2BRobots/ThunderBolt-Nova/Ejemplos/MikroC/ServoADC/ServoADC.mcppi_callertable.txt

main
	ADC_Read
	Mul_16X16_U
	Div_16x16_S
		Div_16x16_S_L
	servo
