2BRobots/ThunderBolt-Nova/Ejemplos/mikroBasic/ServoPot/ServoADC.mbppi_callertable.txt

main
	ADC_Init_Advanced
	ADC_Get_Sample
		Delay_22us
	servo
