2BRobots/ThunderBolt-Nova/README.txt

2B Robots (DAFR Electronics) invierte tiempo y recursos en la elaboración de este contenido. Si usted valora nuestro trabajo duro por favor compre nuestros productos o realize una pequeña donacion. Este trabajo se comparte bajo una licencia Creative Commons BY-NC-SA.

Gracias :)

www.2brobots.com
