2BRobots/ThunderBolt-Nova/Ejemplos/MPLAB/ThunderBolt MPLAB example/README.txt

Este es un ejemplo de un programa funcional en MPLAB simplificado. 
Puedes usarlo como plantilla para iniciar tus proyectos.
No hace falta configurar nada mas.
