2BRobots/ThunderBolt-Nova/Ejemplos/MPLAB/Thunder_Bolt_Blinker_template.X/README.txt

Agradecimientos especiales a Leopoldo De Silva Ortiz por enviar la plantilla para hacer un proyecto con ThunderBolt Nova en MPLAB.
