2BRobots/ThunderBolt-Nova/Documentacion/Diagrama - ThunderBolt Nova Pico.pdf

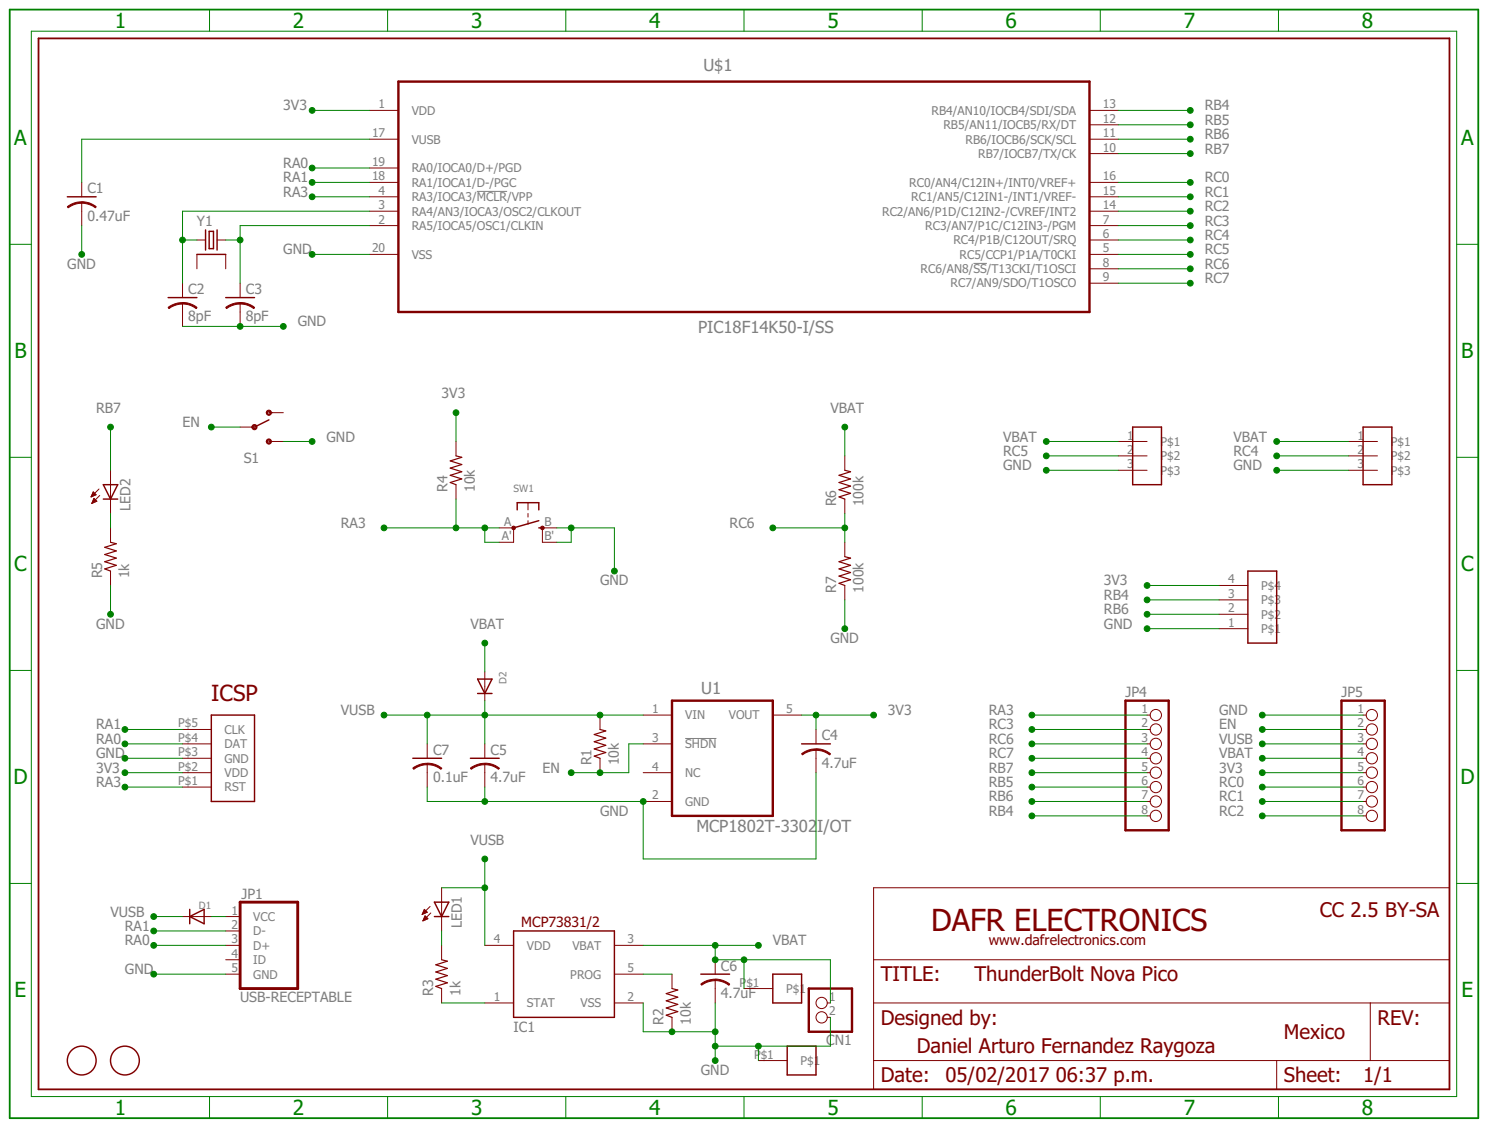
[picture p2: page 1]

CC 2.5 BY-SA DAFR ELECTRONICS

Designed by: Mexico Daniel Arturo Fernandez Raygoza | REV:

Date: 05/02/2017 06:37 p.m. | Sheet: 1/1
