2BRobots/ThunderBolt-Nova/Expansion Boards/Lora_RN2903A/ThunderBolt Lora.brd

## EAGLE design Expansion Boards/Lora_RN2903A/ThunderBolt Lora.brd (2020-08-20)

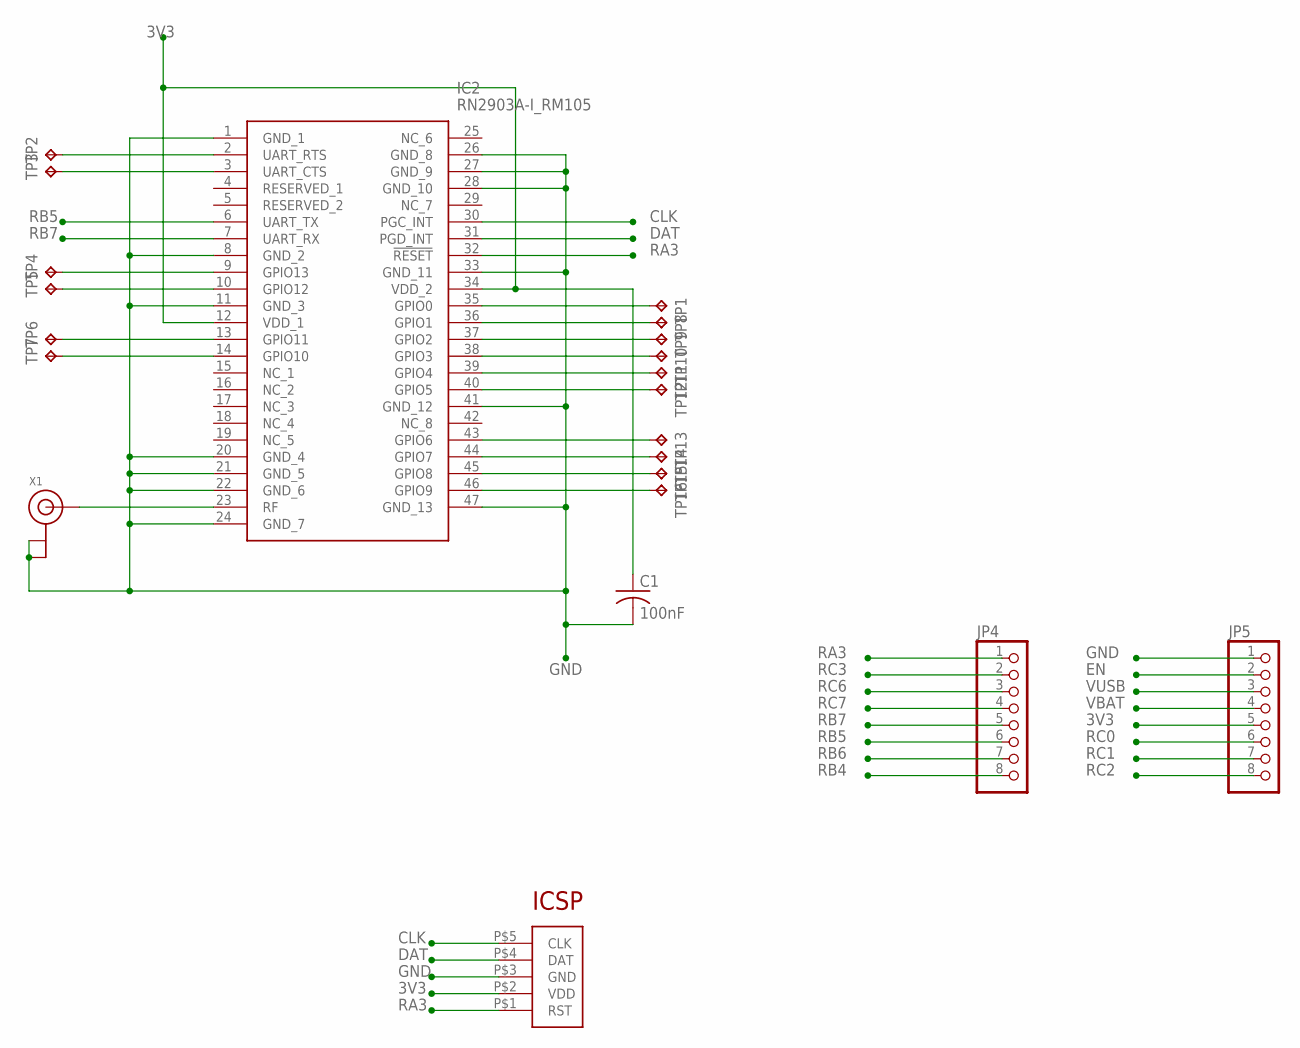
[picture p3: schematic ThunderBolt Lora.sch]

Parts:
C1: 100nF; C0603K
IC2: RN2903A-I_RM105; RN2903AIRM105
JP4, JP5: PINHD-1X8BIG; 1X08-BIG
TP1, TP2, TP3, TP4, TP5, TP6, TP7, TP8, TP9, TP10, TP11, TP12, TP13, TP14, TP15, TP16: TPB1,27; B1,27
U$2: ICSP_POGO
X1: ANTENNA_U.FL; U.FL

Connections:
3V3: C1.1, IC2.12 (VDD_1), IC2.34 (VDD_2), JP5.5, U$2.P$2 (VDD)
CLK: IC2.30 (PGC_INT), U$2.P$5 (CLK)
DAT: IC2.31 (PGD_INT), U$2.P$4 (DAT)
EN: JP5.2
GND: C1.2, IC2.1 (GND_1), IC2.8 (GND_2), IC2.11 (GND_3), IC2.20 (GND_4), IC2.21 (GND_5), IC2.22 (GND_6), IC2.24 (GND_7), IC2.26 (GND_8), IC2.27 (GND_9), IC2.28 (GND_10), IC2.33 (GND_11), IC2.41 (GND_12), IC2.47 (GND_13), JP5.1, U$2.P$3 (GND), X1.1 (GND), X1.2 (GND)
unnamed: IC2.2 (UART_RTS), TP2.TP
unnamed: IC2.3 (UART_CTS), TP3.TP
unnamed: IC2.9 (GPIO13), TP4.TP
unnamed: IC2.10 (GPIO12), TP5.TP
unnamed: IC2.23 (RF), X1.3 (SIGNAL)
unnamed: IC2.13 (GPIO11), TP6.TP
unnamed: IC2.14 (GPIO10), TP7.TP
unnamed: IC2.35 (GPIO0), TP1.TP
unnamed: IC2.46 (GPIO9), TP16.TP
unnamed: IC2.45 (GPIO8), TP15.TP
unnamed: IC2.44 (GPIO7), TP14.TP
unnamed: IC2.43 (GPIO6), TP13.TP
unnamed: IC2.40 (GPIO5), TP12.TP
unnamed: IC2.39 (GPIO4), TP11.TP
unnamed: IC2.38 (GPIO3), TP10.TP
unnamed: IC2.37 (GPIO2), TP9.TP
unnamed: IC2.36 (GPIO1), TP8.TP
RA3: IC2.32 (!RESET), JP4.1, U$2.P$1 (RST)
RB4: JP4.8
RB5: IC2.6 (UART_TX), JP4.6
RB6: JP4.7
RB7: IC2.7 (UART_RX), JP4.5
RC0: JP5.6
RC1: JP5.7
RC2: JP5.8
RC3: JP4.2
RC6: JP4.3
RC7: JP4.4
VBAT: JP5.4
VUSB: JP5.3

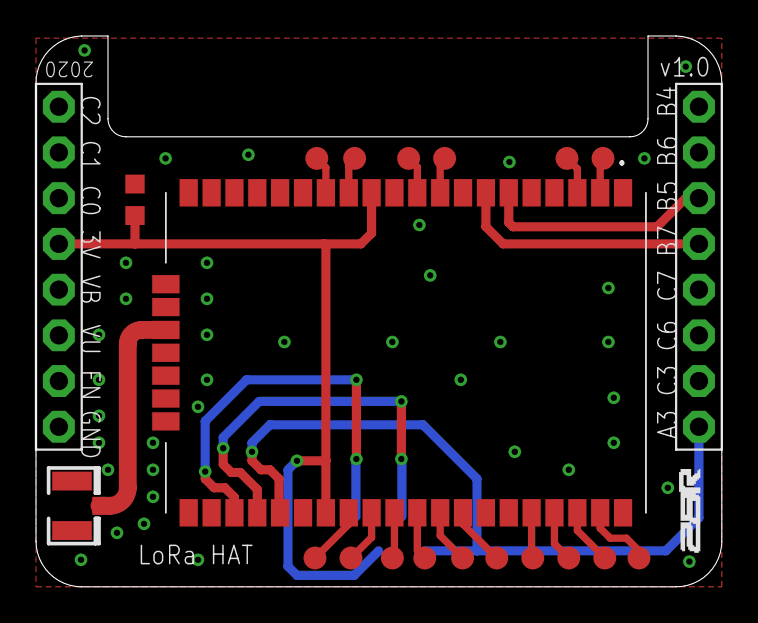
[picture p4: board ThunderBolt Lora.brd from above]

Board: 2 copper layers, 38.1 x 30.6 mm, 22 parts (1 on the bottom side), 24 nets.
