2BRobots/ThunderBolt-Nova/hardware/ThunderBolt Nova/ThunderBolt Nova.sch

## EAGLE design hardware/ThunderBolt Nova/ThunderBolt Nova.sch (2017-04-14)

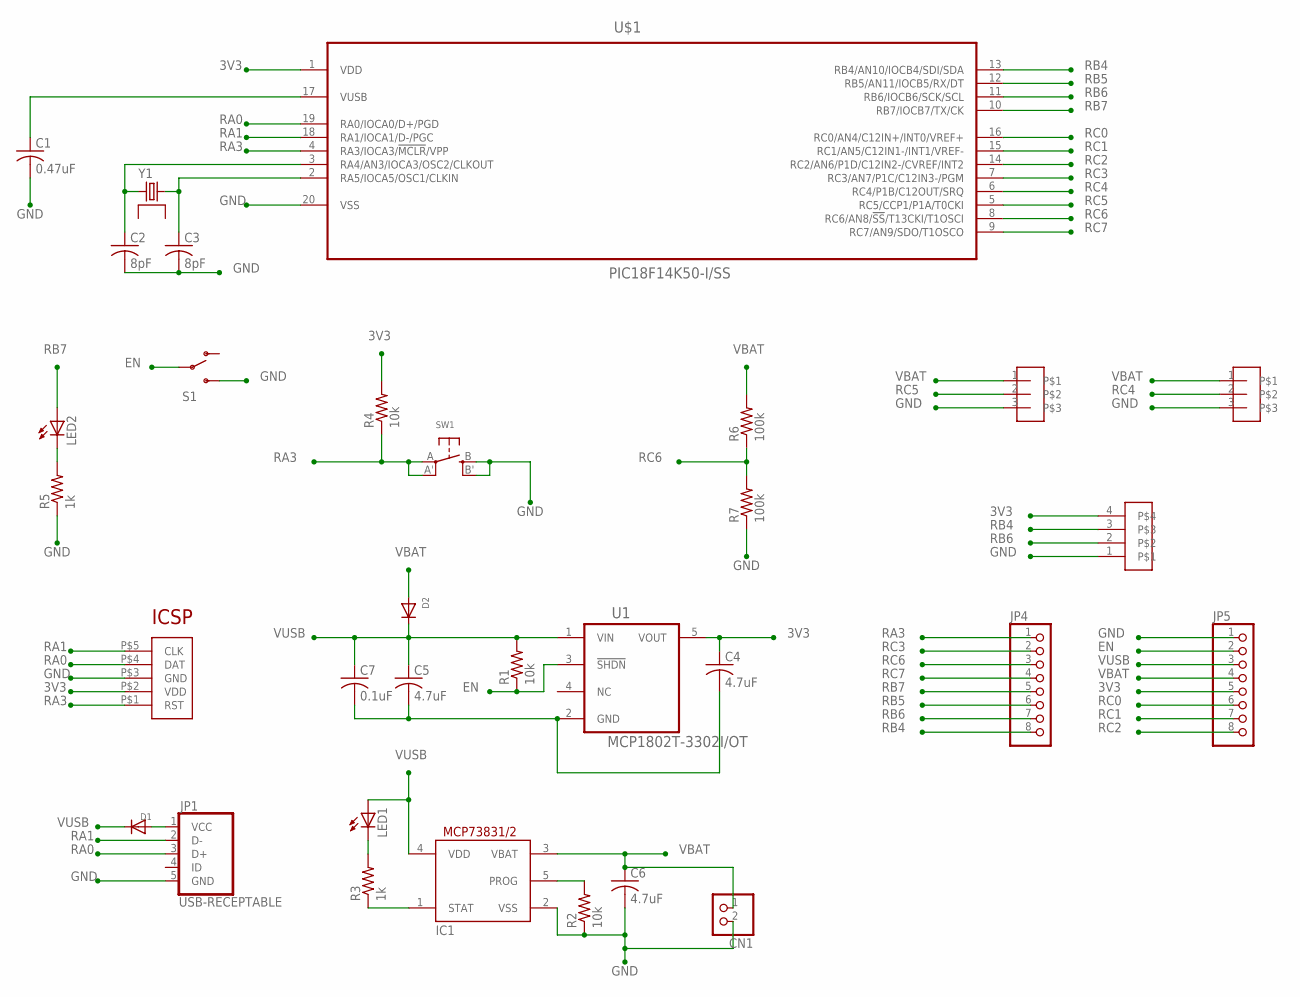
[picture p7: schematic ThunderBolt Nova.sch]

Parts:
C1: 0.47uF; C0805K
C2, C3: 8pF; C0805K
C4, C5, C6: 4.7uF; C0805K
C7: 0.1uF; C0603K
CN1: JST_2PIN-SMT-RA; JST-PH-2-SMT-RA
D1, D2: DIODESOD-123; SOD-123
IC1: MCP73831/OT; SOT23-5L
JP1: USB-RECEPTABLE; FCI-10103594-0001LF
JP4, JP5: PINHD-1X8BIG; 1X08-BIG
LED1, LED2: LEDCHIPLED_1206; CHIPLED_1206
R1, R2, R4: 10k; R0805
R3, R5: 1k; R0805
R6, R7: 100k; R0805
S1: SWITCH-SPDT-SMD-A; SWITCH-SPST-SMD-A
SW1: SWITCH_TACT_SMT4.6X2.8; BTN_KMR2_4.6X2.8
U1: MCP1802T-3302I/OT; SOT95P270X145-5N
U$1: PIC18F14K50-I/SS; SOP65P780X200-20N
U$2: ICSP_POGO
U$5, U$6: PIN1X3
U$7: PIN1X4
Y1: GRX-330; OSC3225

Connections:
3V3: C4.1, JP5.5, R4.2, U1.5 (VOUT), U$1.1 (VDD), U$2.P$2 (VDD), U$7.4
EN: JP5.2, R1.1, S1.2, U1.3 (!SHDN)
GND: C1.2, C2.2, C3.2, C6.2, CN1.2 (1), IC1.2 (VSS), JP1.5 (GND), JP5.1, R2.1, R5.1, R7.1, S1.3 (S), SW1.B (S), SW1.B' (S1), U$1.20 (VSS), U$2.P$3 (GND), U$5.3, U$6.3, U$7.1
unnamed: C1.1, U$1.17 (VUSB)
unnamed: C2.1, U$1.3 (RA4/AN3/IOCA3/OSC2/CLKOUT), Y1.P$1 (1)
unnamed: C3.1, U$1.2 (RA5/IOCA5/OSC1/CLKIN), Y1.P$3 (3)
unnamed: D1.A, JP1.1 (VCC)
unnamed: C4.2, C5.2, C7.2, U1.2 (GND)
unnamed: IC1.1 (STAT), R3.1
unnamed: LED1.C, R3.2
unnamed: IC1.5 (PROG), R2.2
unnamed: LED2.C, R5.2
RA0: JP1.3 (D+), U$1.19 (RA0/IOCA0/D+/PGD), U$2.P$4 (DAT)
RA1: JP1.2 (D-), U$1.18 (RA1/IOCA1/D-/PGC), U$2.P$5 (CLK)
RA3: JP4.1, R4.1, SW1.A, SW1.A' (P1), U$1.4 (RA3/IOCA3/!MCLR!/VPP), U$2.P$1 (RST)
RB4: JP4.8, U$1.13 (RB4/AN10/IOCB4/SDI/SDA), U$7.3
RB5: JP4.6, U$1.12 (RB5/AN11/IOCB5/RX/DT)
RB6: JP4.7, U$1.11 (RB6/IOCB6/SCK/SCL), U$7.2
RB7: JP4.5, LED2.A, U$1.10 (RB7/IOCB7/TX/CK)
RC0: JP5.6, U$1.16 (RC0/AN4/C12IN+/INT0/VREF+)
RC1: JP5.7, U$1.15 (RC1/AN5/C12IN1-/INT1/VREF-)
RC2: JP5.8, U$1.14 (RC2/AN6/P1D/C12IN2-/CVREF/INT2)
RC3: JP4.2, U$1.7 (RC3/AN7/P1C/C12IN3-/PGM)
RC4: U$1.6 (RC4/P1B/C12OUT/SRQ), U$5.2
RC5: U$1.5 (RC5/CCP1/P1A/T0CKI), U$6.2
RC6: JP4.3, R6.1, R7.2, U$1.8 (RC6/AN8/!SS!/T13CKI/T1OSCI)
RC7: JP4.4, U$1.9 (RC7/AN9/SDO/T1OSCO)
VBAT: C6.1, CN1.1 (2), D2.A, IC1.3 (VBAT), JP5.4, R6.2, U$5.1, U$6.1
VUSB: C5.1, C7.1, D1.C, D2.C, IC1.4 (VDD), JP5.3, LED1.A, R1.2, U1.1 (VIN)
