2BRobots/ThunderBolt-Nova/Ejemplos/MPLAB/ThunderBolt MPLAB example/main.c

/*
 * Example project using ThunderBolt Nova Pico, you can use this to start programming your script. 
 * 2B Robots 2017 - MIT License
 */
#include <p18f14k50.h>

/** F U S E S  C O N F I G *******************************************/
 
// CONFIG1L
#pragma config CPUDIV = NOCLKDIV// CPU System Clock Selection bits (No CPU System Clock divide)
#pragma config USBDIV = OFF     // USB Clock Selection bit (USB clock comes directly from the OSC1/OSC2 oscillator block; no divide)

// CONFIG1H
#pragma config FOSC = HS        // Oscillator Selection bits (HS oscillator)
#pragma config PLLEN = ON       // 4 X PLL Enable bit (Oscillator multiplied by 4)
#pragma config PCLKEN = ON      // Primary Clock Enable bit (Primary clock enabled)
#pragma config FCMEN = OFF      // Fail-Safe Clock Monitor Enable (Fail-Safe Clock Monitor disabled)
#pragma config IESO = OFF       // Internal/External Oscillator Switchover bit (Oscillator Switchover mode disabled)

// CONFIG2L
#pragma config PWRTEN = ON      // Power-up Timer Enable bit (PWRT enabled)
#pragma config BOREN = ON       // Brown-out Reset Enable bits (Brown-out Reset enabled and controlled by software (SBOREN is enabled))
#pragma config BORV = 22        // Brown-out Reset Voltage bits (VBOR set to 2.2 V nominal)

// CONFIG2H
#pragma config WDTEN = OFF      // Watchdog Timer Enable bit (WDT is controlled by SWDTEN bit of the WDTCON register)
#pragma config WDTPS = 32768    // Watchdog Timer Postscale Select bits (1:32768)

// CONFIG3H
#pragma config HFOFST = OFF     // HFINTOSC Fast Start-up bit (The system clock is held off until the HFINTOSC is stable.)
#pragma config MCLRE = OFF      // MCLR Pin Enable bit (RA3 input pin enabled; MCLR disabled)

// CONFIG4L
#pragma config STVREN = ON      // Stack Full/Underflow Reset Enable bit (Stack full/underflow will cause Reset)
#pragma config LVP = OFF        // Single-Supply ICSP Enable bit (Single-Supply ICSP disabled)
#pragma config BBSIZ = OFF      // Boot Block Size Select bit (1kW boot block size)
#pragma config XINST = OFF      // Extended Instruction Set Enable bit (Instruction set extension and Indexed Addressing mode disabled (Legacy mode))

// CONFIG5L
#pragma config CP0 = OFF        // Code Protection bit (Block 0 not code-protected)
#pragma config CP1 = OFF        // Code Protection bit (Block 1 not code-protected)

// CONFIG5H
#pragma config CPB = OFF        // Boot Block Code Protection bit (Boot block not code-protected)
#pragma config CPD = OFF        // Data EEPROM Code Protection bit (Data EEPROM not code-protected)

// CONFIG6L
#pragma config WRT0 = OFF       // Table Write Protection bit (Block 0 not write-protected)
#pragma config WRT1 = OFF       // Table Write Protection bit (Block 1 not write-protected)

// CONFIG6H
#pragma config WRTC = OFF       // Configuration Register Write Protection bit (Configuration registers not write-protected)
#pragma config WRTB = OFF       // Boot Block Write Protection bit (Boot block not write-protected)
#pragma config WRTD = OFF       // Data EEPROM Write Protection bit (Data EEPROM not write-protected)

// CONFIG7L
#pragma config EBTR0 = OFF      // Table Read Protection bit (Block 0 not protected from table reads executed in other blocks)
#pragma config EBTR1 = OFF      // Table Read Protection bit (Block 1 not protected from table reads executed in other blocks)

// CONFIG7H
#pragma config EBTRB = OFF      // Boot Block Table Read Protection bit (Boot block not protected from table reads executed in other blocks) 

#define _XTAL_FREQ (48000000ULL) 


/** V E C T O R  R E M A P P I N G *******************************************/
#define REMAPPED_RESET_VECTOR_ADDRESS			0x1000
#define REMAPPED_HIGH_INTERRUPT_VECTOR_ADDRESS	0x1008
#define REMAPPED_LOW_INTERRUPT_VECTOR_ADDRESS	0x1018
//#define BOOTLOADER_PROGRAMMING_ENTRY_ADDRESS	0x30

void HighPriorityISRCode();
void LowPriorityISRCode();

extern void _startup (void);        // See c018i.c in your C18 compiler dir
#pragma code REMAPPED_RESET_VECTOR = REMAPPED_RESET_VECTOR_ADDRESS
void _reset (void) { _asm goto _startup _endasm }

#pragma code REMAPPED_HIGH_INTERRUPT_VECTOR = REMAPPED_HIGH_INTERRUPT_VECTOR_ADDRESS
void Remapped_High_ISR (void) { _asm goto HighPriorityISRCode _endasm }

#pragma code REMAPPED_LOW_INTERRUPT_VECTOR = REMAPPED_LOW_INTERRUPT_VECTOR_ADDRESS
void Remapped_Low_ISR (void) { _asm goto LowPriorityISRCode _endasm }

#pragma code HIGH_INTERRUPT_VECTOR = 0x08
void High_ISR (void) { _asm goto REMAPPED_HIGH_INTERRUPT_VECTOR_ADDRESS _endasm }
#pragma code LOW_INTERRUPT_VECTOR = 0x18
void Low_ISR (void) { _asm goto REMAPPED_LOW_INTERRUPT_VECTOR_ADDRESS _endasm }

/** I N T E R R U P S  P R O G R A M *******************************************/
#pragma code

#pragma interrupt HighPriorityISRCode
void HighPriorityISRCode()  //high priority interrupt code
{
    
}

#pragma interruptlow LowPriorityISRCode
void LowPriorityISRCode() //low priority interrupt code
{
    
}


/** M A I N   P R O G R A M *******************************************/
void main(void) 
{
    TRISBbits.TRISB7 = 0; //config port B7 as output 
    while(1)
    {
        if (PORTAbits.RA3 == 0) //if the button is pressed
        {
            LATBbits.LATB7= 0; //turn off the built in LED
        }
        else //if not
        {
            LATBbits.LATB7= 1; //turn it on
        }
    }  
    return;
}

 
