2BRobots/ThunderBolt-Nova/Ejemplos/MikroC/blynkInterrupt/blynkInterrupt.asm

_interrupt:

;blynkInterrupt.c,19 :: 		void interrupt()
;blynkInterrupt.c,23 :: 		if (INTCON.f2 == 1) //si se desborda el timer y acciona la interrupcion, este registro es una bandera
	BTFSS       INTCON+0, 2 
	GOTO        L_interrupt0
;blynkInterrupt.c,27 :: 		T0CON.f7 = 0;
	BCF         T0CON+0, 7 
;blynkInterrupt.c,29 :: 		unresolved line
	BCF         INTCON+0, 2 
;blynkInterrupt.c,31 :: 		unresolved line
	CLRF        TMR0H+0 
;blynkInterrupt.c,33 :: 		unresolved line
	CLRF        TMR0L+0 
;blynkInterrupt.c,35 :: 		unresolved line
	BTG         LATB+0, 7 
;blynkInterrupt.c,39 :: 		unresolved line
	MOVLW       0
	XORWF       _var1+1, 0 
	BTFSS       STATUS+0, 2 
	GOTO        L__interrupt13
	MOVLW       10
	XORWF       _var1+0, 0 
L__interrupt13:
	BTFSS       STATUS+0, 2 
	GOTO        L_interrupt1
;blynkInterrupt.c,41 :: 		unresolved line
	BTG         LATC+0, 0 
;blynkInterrupt.c,42 :: 		unresolved line
	CLRF        _var1+0 
	CLRF        _var1+1 
;blynkInterrupt.c,43 :: 		unresolved line
	GOTO        L_interrupt2
L_interrupt1:
;blynkInterrupt.c,46 :: 		unresolved line
	INFSNZ      _var1+0, 1 
	INCF        _var1+1, 1 
;blynkInterrupt.c,47 :: 		unresolved line
L_interrupt2:
;blynkInterrupt.c,48 :: 		unresolved line
	MOVLW       0
	XORWF       _var2+1, 0 
	BTFSS       STATUS+0, 2 
	GOTO        L__interrupt14
	MOVLW       100
	XORWF       _var2+0, 0 
L__interrupt14:
	BTFSS       STATUS+0, 2 
	GOTO        L_interrupt3
;blynkInterrupt.c,50 :: 		unresolved line
	BTG         LATC+0, 1 
;blynkInterrupt.c,51 :: 		unresolved line
	CLRF        _var2+0 
	CLRF        _var2+1 
;blynkInterrupt.c,52 :: 		unresolved line
	GOTO        L_interrupt4
L_interrupt3:
;blynkInterrupt.c,55 :: 		unresolved line
	INFSNZ      _var2+0, 1 
	INCF        _var2+1, 1 
;blynkInterrupt.c,56 :: 		unresolved line
L_interrupt4:
;blynkInterrupt.c,57 :: 		unresolved line
	MOVF        _var3+1, 0 
	XORLW       1
	BTFSS       STATUS+0, 2 
	GOTO        L__interrupt15
	MOVLW       244
	XORWF       _var3+0, 0 
L__interrupt15:
	BTFSS       STATUS+0, 2 
	GOTO        L_interrupt5
;blynkInterrupt.c,59 :: 		unresolved line
	BTG         LATC+0, 2 
;blynkInterrupt.c,60 :: 		unresolved line
	CLRF        _var3+0 
	CLRF        _var3+1 
;blynkInterrupt.c,61 :: 		unresolved line
	GOTO        L_interrupt6
L_interrupt5:
;blynkInterrupt.c,64 :: 		unresolved line
	INFSNZ      _var3+0, 1 
	INCF        _var3+1, 1 
;blynkInterrupt.c,65 :: 		unresolved line
L_interrupt6:
;blynkInterrupt.c,66 :: 		unresolved line
	BSF         T0CON+0, 7 
;blynkInterrupt.c,68 :: 		unresolved line
L_interrupt0:
;blynkInterrupt.c,70 :: 		unresolved line
L_end_interrupt:
L__interrupt12:
	RETFIE      1
; end of _interrupt

_main:

;blynkInterrupt.c,76 :: 		unresolved line
;blynkInterrupt.c,80 :: 		unresolved line
	MOVLW       8
	MOVWF       TRISA+0 
;blynkInterrupt.c,82 :: 		unresolved line
	CLRF        TRISB+0 
;blynkInterrupt.c,84 :: 		unresolved line
	CLRF        TRISC+0 
;blynkInterrupt.c,89 :: 		unresolved line
	CLRF        LATA+0 
;blynkInterrupt.c,91 :: 		unresolved line
	CLRF        LATB+0 
;blynkInterrupt.c,93 :: 		unresolved line
	CLRF        LATC+0 
;blynkInterrupt.c,98 :: 		unresolved line
	MOVLW       1
	MOVWF       T0CON+0 
;blynkInterrupt.c,100 :: 		unresolved line
	CLRF        TMR0H+0 
;blynkInterrupt.c,102 :: 		unresolved line
	CLRF        TMR0L+0 
;blynkInterrupt.c,104 :: 		unresolved line
	MOVLW       224
	MOVWF       INTCON+0 
;blynkInterrupt.c,106 :: 		unresolved line
	BCF         RCON+0, 7 
;blynkInterrupt.c,108 :: 		unresolved line
	BSF         T0CON+0, 7 
;blynkInterrupt.c,113 :: 		unresolved line
L_main7:
;blynkInterrupt.c,117 :: 		unresolved line
	BTFSC       PORTA+0, 3 
	GOTO        L_main9
;blynkInterrupt.c,121 :: 		unresolved line
	GOTO        48
;blynkInterrupt.c,123 :: 		unresolved line
L_main9:
;blynkInterrupt.c,125 :: 		unresolved line
	MOVLW       7
	MOVWF       R11, 0
	MOVLW       23
	MOVWF       R12, 0
	MOVLW       106
	MOVWF       R13, 0
L_main10:
	DECFSZ      R13, 1, 1
	BRA         L_main10
	DECFSZ      R12, 1, 1
	BRA         L_main10
	DECFSZ      R11, 1, 1
	BRA         L_main10
	NOP
;blynkInterrupt.c,129 :: 		unresolved line
	GOTO        L_main7
;blynkInterrupt.c,131 :: 		unresolved line
L_end_main:
	GOTO        $+0
; end of _main

_bootInterrupt:

;blynkInterrupt.c,136 :: 		unresolved line
;blynkInterrupt.c,142 :: 		unresolved line
	GOTO        _main+0
;blynkInterrupt.c,144 :: 		unresolved line
	GOTO        0
;blynkInterrupt.c,146 :: 		unresolved line
	GOTO        _interrupt+0
;blynkInterrupt.c,150 :: 		unresolved line
L_end_bootInterrupt:
	RETURN      0
; end of _bootInterrupt
