2BRobots/ThunderBolt-Nova/Ejemplos/mikroBasic/buzzer_marcha_imperial/buzzer.asm

_main:

;buzzer.mbas,25 :: 		org 0x1000
;buzzer.mbas,27 :: 		TRISC.3 = 0
	BCF         TRISC+0, 3 
;buzzer.mbas,28 :: 		Sound_Init(LATC,3)
	MOVLW       LATC+0
	MOVWF       FARG_Sound_Init_snd_port+0 
	MOVLW       hi_addr(LATC+0)
	MOVWF       FARG_Sound_Init_snd_port+1 
	MOVLW       3
	MOVWF       FARG_Sound_Init_snd_pin+0 
	CALL        _Sound_Init+0, 0
;buzzer.mbas,30 :: 		loop:
L__main_loop:
;buzzer.mbas,32 :: 		Sound_play(a, 500)
	MOVLW       184
	MOVWF       FARG_Sound_Play_freq_in_hz+0 
	MOVLW       1
	MOVWF       FARG_Sound_Play_freq_in_hz+1 
	MOVLW       244
	MOVWF       FARG_Sound_Play_duration_ms+0 
	MOVLW       1
	MOVWF       FARG_Sound_Play_duration_ms+1 
	CALL        _Sound_Play+0, 0
;buzzer.mbas,33 :: 		Sound_play(a, 500)
	MOVLW       184
	MOVWF       FARG_Sound_Play_freq_in_hz+0 
	MOVLW       1
	MOVWF       FARG_Sound_Play_freq_in_hz+1 
	MOVLW       244
	MOVWF       FARG_Sound_Play_duration_ms+0 
	MOVLW       1
	MOVWF       FARG_Sound_Play_duration_ms+1 
	CALL        _Sound_Play+0, 0
;buzzer.mbas,34 :: 		Sound_play(a, 500)
	MOVLW       184
	MOVWF       FARG_Sound_Play_freq_in_hz+0 
	MOVLW       1
	MOVWF       FARG_Sound_Play_freq_in_hz+1 
	MOVLW       244
	MOVWF       FARG_Sound_Play_duration_ms+0 
	MOVLW       1
	MOVWF       FARG_Sound_Play_duration_ms+1 
	CALL        _Sound_Play+0, 0
;buzzer.mbas,35 :: 		Sound_play(f, 350)
	MOVLW       93
	MOVWF       FARG_Sound_Play_freq_in_hz+0 
	MOVLW       1
	MOVWF       FARG_Sound_Play_freq_in_hz+1 
	MOVLW       94
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
	MOVLW       129
	MOVWF       R13, 0
L__main8:
	DECFSZ      R13, 1, 1
	BRA         L__main8
	DECFSZ      R12, 1, 1
	BRA         L__main8
	DECFSZ      R11, 1, 1
	BRA         L__main8
	NOP
	NOP
;buzzer.mbas,121 :: 		goto loop
	GOTO        L__main_loop
L_end_main:
	GOTO        $+0
; end of _main
