2BRobots/ThunderBolt-Nova/Ejemplos/MPLAB/Thunder_Bolt_Blinker_template.X/system.h

/******************************************************************************/
/* System Level #define Macros                                                */
/******************************************************************************/

/* TODO Define system operating frequency */
#include <p18f14k50.h>
/* Microcontroller MIPs (FCY) */
#define SYS_FREQ        48000000L //
#define FCY             SYS_FREQ/4



/******************************************************************************/
/* System Function Prototypes                                                 */
/******************************************************************************/

/* Custom oscillator configuration funtions, reset source evaluation
functions, and other non-peripheral microcontroller initialization functions
go here. */

void ConfigureOscillator(void); /* Handles clock switching/osc initialization */
