2BRobots/ThunderBolt-Nova/(commit log)

2017-05-20 examples added
    [LCD_i2c.cfg, PWM_ADC.cfg, ServoADC.cfg, TMP007.cfg]
2017-06-17 added examples
    [Led_bluetooth.cfg, Timer_interrupt.cfg, botones.cfg, display7segmentos.cfg]
2017-08-18 corrections in examples
    [Servo.cfg, ThunderBolt Nova Pico.brd, ThunderBolt Nova Pico.sch, ThunderBolt Nova.brd, Timer_interrupt.cfg, blink.cfg, botones.cfg, siguelineas.cfg]
2017-08-26 added example
    [buzzer.cfg]
2017-09-10 added interrupt example
    code for mikroC
    [blynkInterrupt.cfg]
2020-08-20 Lora shield
    [ThunderBolt Lora.brd, ThunderBolt Lora.sch]
