2BRobots/ThunderBolt-Nova/(notices)

Notices in the files:
parts and their libraries:
golledge_full_v1-0: © Golledge Electronics Ltd 2015. Released under GNU General Public License. Full library V1.0.
SparkFun-Electromechanical: Licensing: Creative Commons ShareAlike 4.0 International - https://creativecommons.org/licenses/by-sa/4.0
